OpenICU-org/ventmon-ventilator-inline-test-monitor/(commit log)

2020-12-01 Updated VentMon PCB to V0.4
    [ventmon_t0.4.brd, ventmon_t0.4.sch]
2020-12-02 Fixed missing 3v3 wire, added groundplane, fixed DRC errors
    [ventmon_t0.4.brd]
2020-12-15 Moved pressure sensors to accomodate small tube
    [ventmon_t0.4.brd, ventmon_t0.4.sch]
2020-12-16 Reduced board width to from 85mm to 75mm to fit in case.
    [ventmon_t0.42.brd, ventmon_t0.42.sch]
