OpenICU-org/ventmon-ventilator-inline-test-monitor/(notices)

Notices in the files:
parts and their libraries:
SparkFun-Coils: Licensing: Creative Commons ShareAlike 4.0 International - https://creativecommons.org/licenses/by-sa/4.0
Wurth_Signal: Copyright: Würth Elektronik
